tsengyuhan/EMIL-Documentation/README.md

# EMIL-Documentation
The documentation of developing hardware design and wearable solutions.

test
