tsengyuhan/EMIL-Documentation/Prototype v1/Main_power_board/Main_power_board.kicad_pcb

## KiCad design Prototype v1/Main_power_board/Main_power_board.kicad_pcb (2024-01-16)

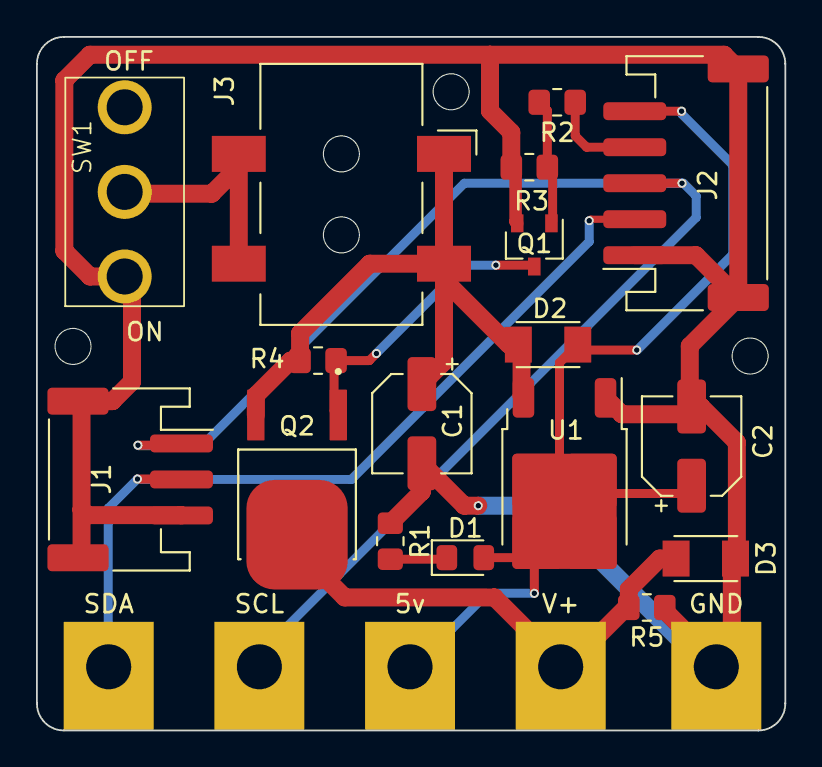
[picture p5: board Main_power_board.kicad_pcb from above]

Board: 2 copper layers, 41.6 x 38.5 mm, 22 parts (0 on the bottom side), 11 nets.

Parts:
5v: MountingHole_Pad; MountingHole_2.5mm_Pad
C1, C2: 10uF; CP_Elec_5x5.4
D1: LED; LED_0805_2012Metric_Pad1.15x1.40mm_HandSolder
D2, D3: DIODE SCHOT 100V 1A MINISMA; SOD-123T
GND: MountingHole_Pad; MountingHole_2.5mm_Pad
J1: CONN HEADER SMD R/A 3POS 2MM; JST_PH_S3B-PH-SM4-TB_1x03-1MP_P2.00mm_Horizontal
J2: CONN HEADER SMD R/A 5POS 2MM; JST_PH_S5B-PH-SM4-TB_1x05-1MP_P2.00mm_Horizontal
J3: CONN PWR JACK 2X5.5MM; CUIDevices_PJ-002AH-SMT-TR_PWRJack_2x5.5mm
Q1: MOSFET N-CH 30V 1.7A SUPERSOT3; SOT-23-3
Q2: MOSFET P-CH 30V 25A DPAK; TO229P990X238-3N
R1: 499; R_0805_2012Metric_Pad1.20x1.40mm_HandSolder
R2, R3, R4: 10K; R_0805_2012Metric_Pad1.20x1.40mm_HandSolder
R5: 1K; R_0805_2012Metric_Pad1.20x1.40mm_HandSolder
SCL: MountingHole_Pad; MountingHole_2.5mm_Pad
SDA: MountingHole_Pad; MountingHole_2.5mm_Pad
SW1: SWITCH SLIDE SPDT 5A 120VAC; SW_SPDTx03_Slide
U1: IC REG LINEAR 5V 1A DPAK; TO-252-2
V+: MountingHole_Pad; MountingHole_2.5mm_Pad

Connections:
Enable: J2.4, R2.1
unnamed: D1.1 (K), R1.2
unnamed: Q1.3 (D), Q2.1 (G), R4.2
unnamed: Q1.1 (G), R2.2, R3.2
unnamed: J3.2, J3.3, SW1.2 (B)
OUTPUT_PWR: D3.1 (K), Q2.2 (D), R5.2, V+.1
PWR_5V: 5v.1, C2.1, D1.2 (A), D2.2 (A), J2.5, U1.2 (VO)
PWR_12V: C1.1, D2.1 (K), J3.1, Q2.3 (S), R4.1, U1.3 (VI)
PWR_GND: C1.2, C2.2, D3.2 (A), GND.1, J1.3, J2.1, Q1.2 (S), R1.1, R3.1, R5.1, SW1.1 (A), U1.1 (GND)
SCL: J1.1, J2.3, SCL.1
SDA: J1.2, J2.2, SDA.1
