tsengyuhan/EMIL-Documentation/Prototype v1/Main_power_board/pics/Main_power_board_assembly_mark.jpg

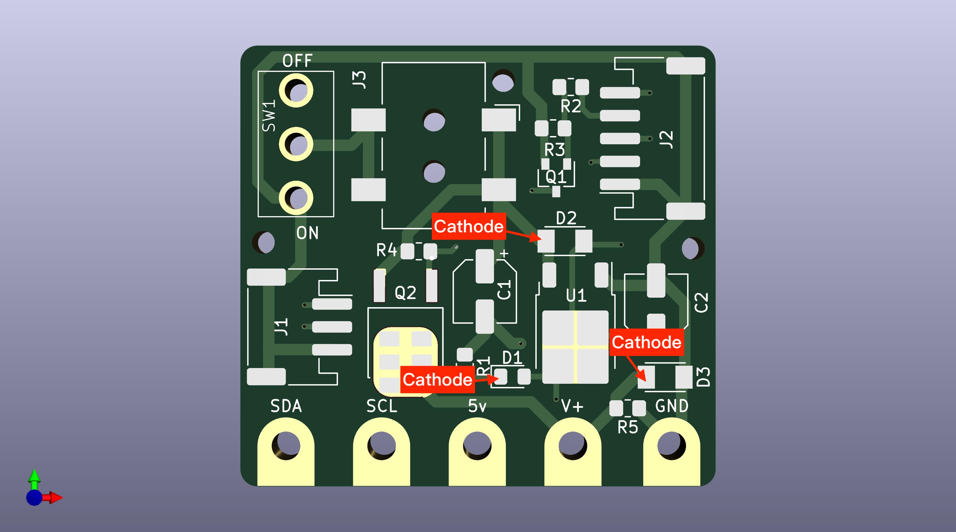
Prototype v1/Main_power_board/pics/Main_power_board_assembly_mark.jpg
