tsengyuhan/EMIL-Documentation/(commit log)

2024-01-16 update Formal prototype v1
    [Peltier_slave.kicad_pcb, Peltier_slave.kicad_pcb_bom.csv, Peltier_slave.kicad_pcb_positions.csv, Peltier_slave.kicad_sch]
2024-01-16 update Prototype v1
    [Peltier_slave.kicad_pcb, Peltier_slave.kicad_pcb_bom.csv, Peltier_slave.kicad_pcb_positions.csv, Peltier_slave.kicad_sch]
2024-01-16 update Prototype v1 peltier slave
2024-01-16 prototype v1 peltier slave update
2024-01-16 prototype v1 update
    [Main_power_board.kicad_pcb, Main_power_board.kicad_pcb_bom.csv, Main_power_board.kicad_pcb_positions.csv, Main_power_board.kicad_sch]
